ril3y/crossgrbl/(commit log)

2026-03-14 Initial commit: CrossGRBL firmware for Langmuir CrossFire CNC
    Modified GRBL firmware (based on Langmuir grbl-ls) targeting Arduino Uno
    with Electronics-Salon screw terminal shield. Includes USB VID/PID spoof
    firmware for FireControl compatibility, THC firmware for torch height
    control, and CI/CD workflows for automated builds and releases.
    [config.h, cpu_map.h, defaults.h]
2026-03-14 Update README: fix BOM, USB flashing, and wiring docs
    - Remove external stepper drivers, relay, and THC from BOM (CrossFire
    has built-in Leadshine drivers and torch trigger circuit)
    - Replace Atmel FLIP instructions with dfu-programmer + Zadig workflow
    - Add --suppress-bootloader-mem flag and chip identification table
    - Update wiring to reference Leadshine driver terminals (PUL+/DIR+/ENA+)
    - Update torch fire section to use CrossFire's built-in trigger circuit
    - Total cost now ~$33 (Arduino + screw terminal shield only)
2026-05-07 Fix X and Y axis direction for Langmuir CrossFire
    - Set DEFAULT_DIRECTION_INVERT_MASK to invert both X and Y axes
    - Add GitHub Actions workflow to build firmware automatically
    - Firmware now plug-and-play for CrossFire with current wiring
    [defaults.h]
2026-05-07 Add dual firmware support for Mach3 and standard CrossFire
    - Updated README with firmware version documentation
    - CI/CD now builds both inverted and standard firmware
    - Inverted firmware for original Mach3 CrossFire conversions
    - Standard firmware for newer Langmuir wiring configurations
    - Release notes explain which version to use
2026-05-07 Add wiring diagram and component links to README
    - Added wiring diagram photo showing completed Arduino setup
    - Added Amazon links for Arduino Uno and screw terminal shield
    - Enhanced hardware requirements table with purchase links
    - Visual reference for users setting up their CrossFire conversion
2026-05-07 Fix steps/mm for Mach3 CrossFire (8TPI lead screws)
    - Changed from 125.984 to 503.936 steps/mm (4x increase)
    - Mach3/Gen1 CrossFire uses 8TPI (3.175mm lead) screws
    - Gen2 uses 0.5" lead (12.7mm) screws - different hardware
    - Verified with physical measurement: 8 threads per inch
    [defaults.h]
2026-05-07 Fix max speed limits to prevent alarm 18 error
    - Reduced 8TPI max speed from 300 IPM to 120 IPM (safe for Arduino step rate)
    - Set 2TPI max speed to 480 IPM (safe with fewer steps/mm)
    - Prevents max step rate exceeded error that caused alarm 18 in FireControl
    The alarm 18 error occurred when commanding 300 IPM with 503.936 steps/mm,
    which required ~64,000 steps/sec (2x Arduino's 30,000 limit).
    [defaults.h]
2026-05-07 Document hardware speed limitations and max speeds
    Added comprehensive explanation of why speeds above 120 IPM (8TPI) or 480 IPM (2TPI)
    don't actually make the machine move faster - they all hit the Arduino Uno's hardware
    limit of ~30,000 steps/second.
    Key additions:
    - Explained why commanding 200 IPM and 300 IPM both result in same speed (~120 IPM)
    - Added calculation examples showing step rate requirements
    - Updated GRBL settings tables with correct max rates for both 8TPI and 2TPI
    - Separated settings into two tables for clarity (8TPI vs 2TPI configs)
    - Added practical implications for plasma cutting speeds
    This helps users understand the hardware limitations and why the firmware
    preven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
2026-05-07 Add example G-code test files
    Added two test files to help users verify their CrossFire setup:
    - test-square.nc: 4" square pattern for axis calibration (no torch fire)
    - Verifies X/Y directions and movement calibration
    - Tests at 120 IPM to confirm max speed settings
    - Safe for initial testing without cutting
    - test-2inch-circle.nc: 2" diameter circle for actual cutting test
    - Generated with Fusion 360 CrossFire post processor
    - Tests torch on/off (M3/M5) commands
    - Verifies diagonal/circular motion and post-flow air
    - Cutting speed: ~40 IPM
    Both files include detailed README with usage instructions and safety notes.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
